Kunalverma1502/ESP-32-Drone-V2.0/README.md

# ESP-32-Drone-V2.0
ESP32 based mini drone
