Kunalverma1502/ESP-32-Drone-V2.0/Body/Body_Bottom.png

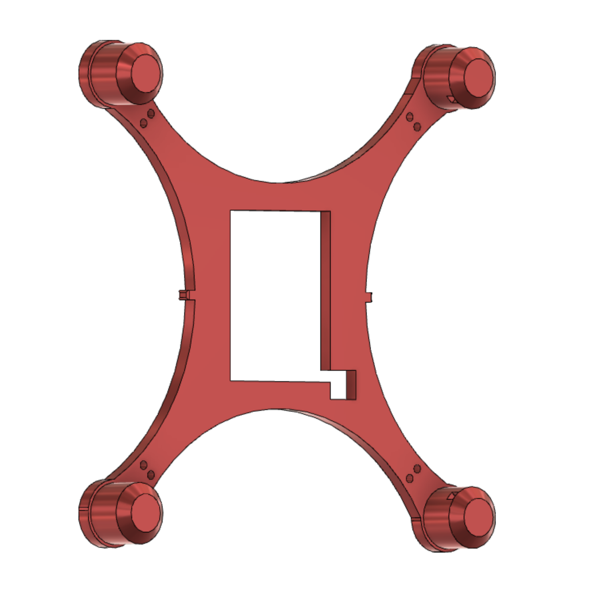
Body/Body_Bottom.png
