Kunalverma1502/ESP-32-Drone-V2.0/Body/Body_Top.png

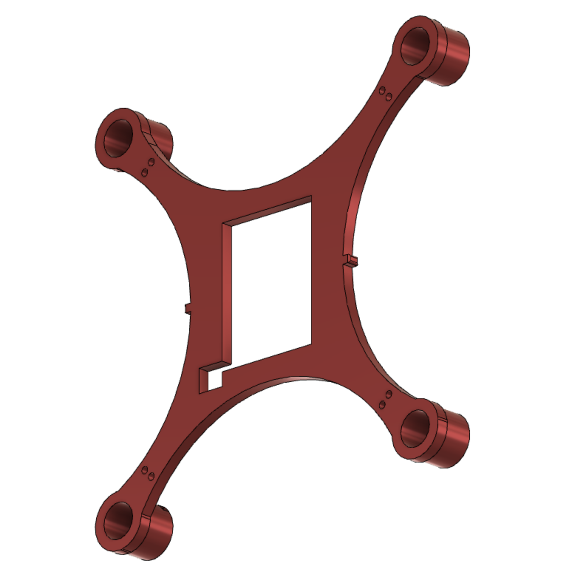
Body/Body_Top.png
