Kunalverma1502/ESP-32-Drone-V2.0/Body/new body v9.step

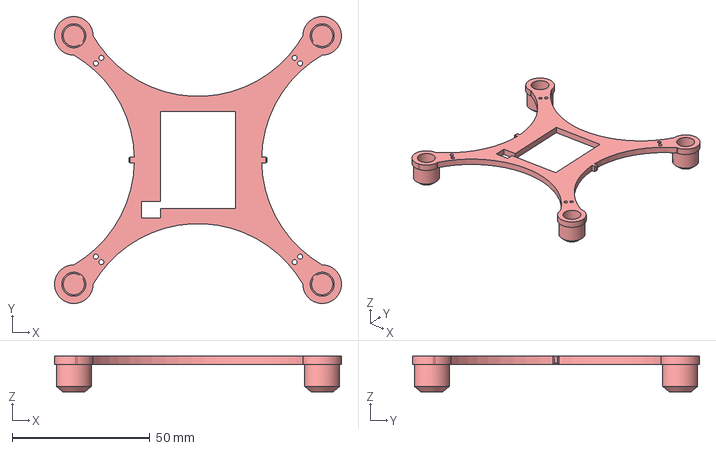
[picture p4: CAD file, 2023-05-19]
Body/new body v9.step
104.0 x 104.0 x 13.0 mm
