Kunalverma1502/ESP-32-Drone-V2.0/(list of files, cad)

Other CAD files:
Body/new body v9.f3z
Body/new body v9.obj
Body/new body v9.stl
