Kunalverma1502/ESP-32-Drone-V2.0/PCB and Schematics/DRONE ORIGNAL/drone.pdf

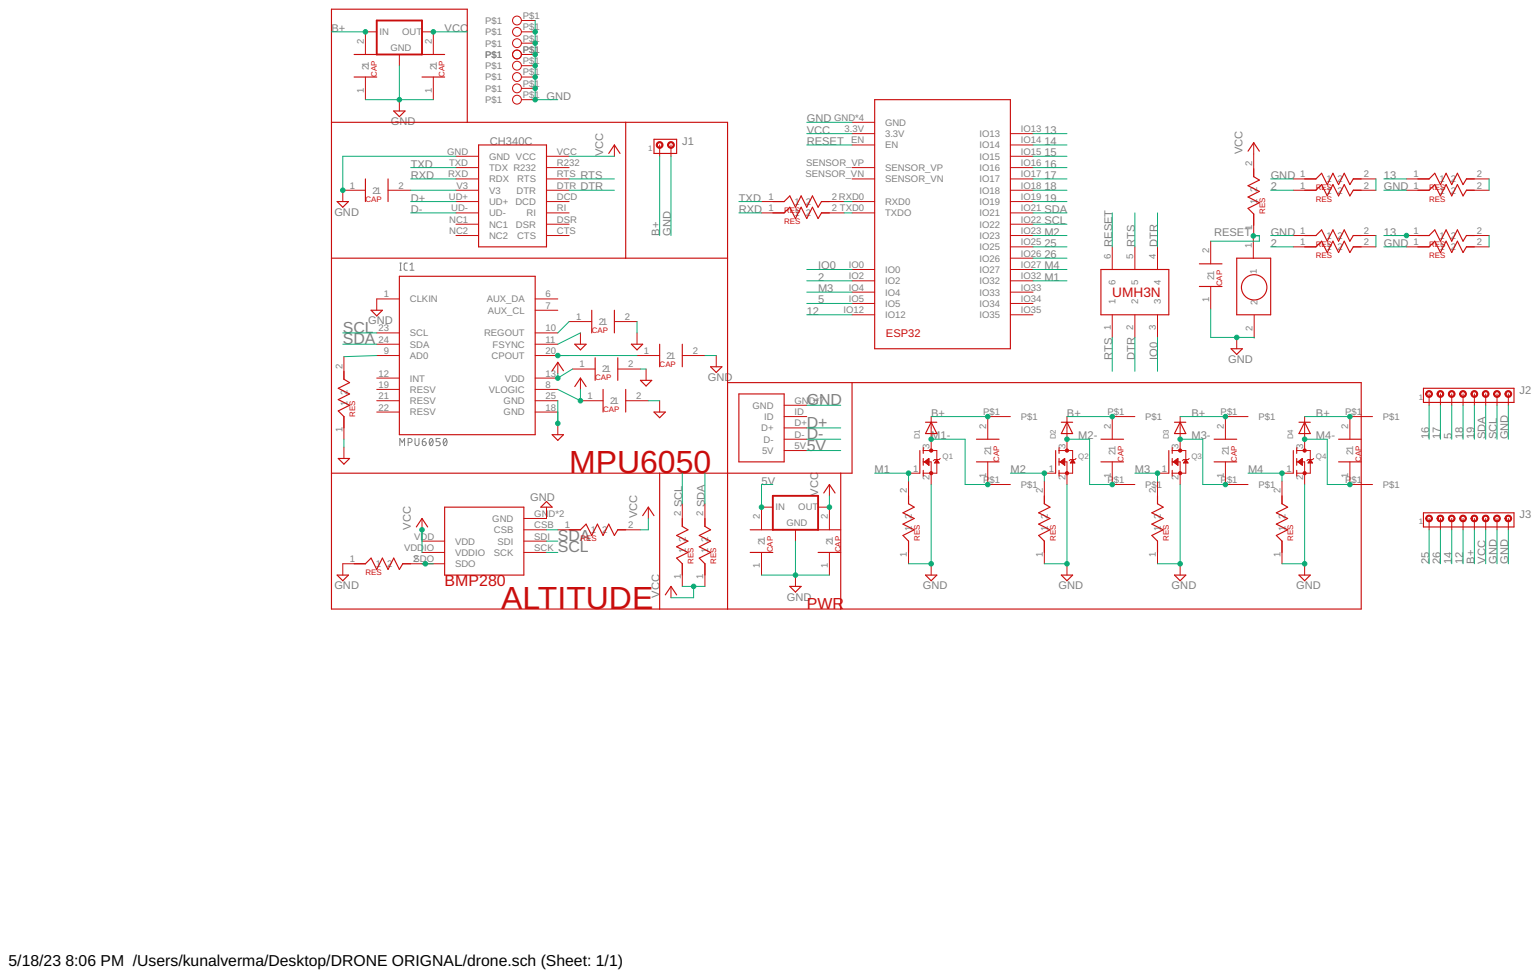
[picture p5: page 1]

GND | 5V

5/18/23 8:06 PM /Users/kunalverma/Desktop/DRONE ORIGNAL/drone.sch (Sheet: 1/1)
