Kunalverma1502/ESP-32-Drone-V2.0/PCB and Schematics/DRONE V2.0/DRONE V3.0.pdf

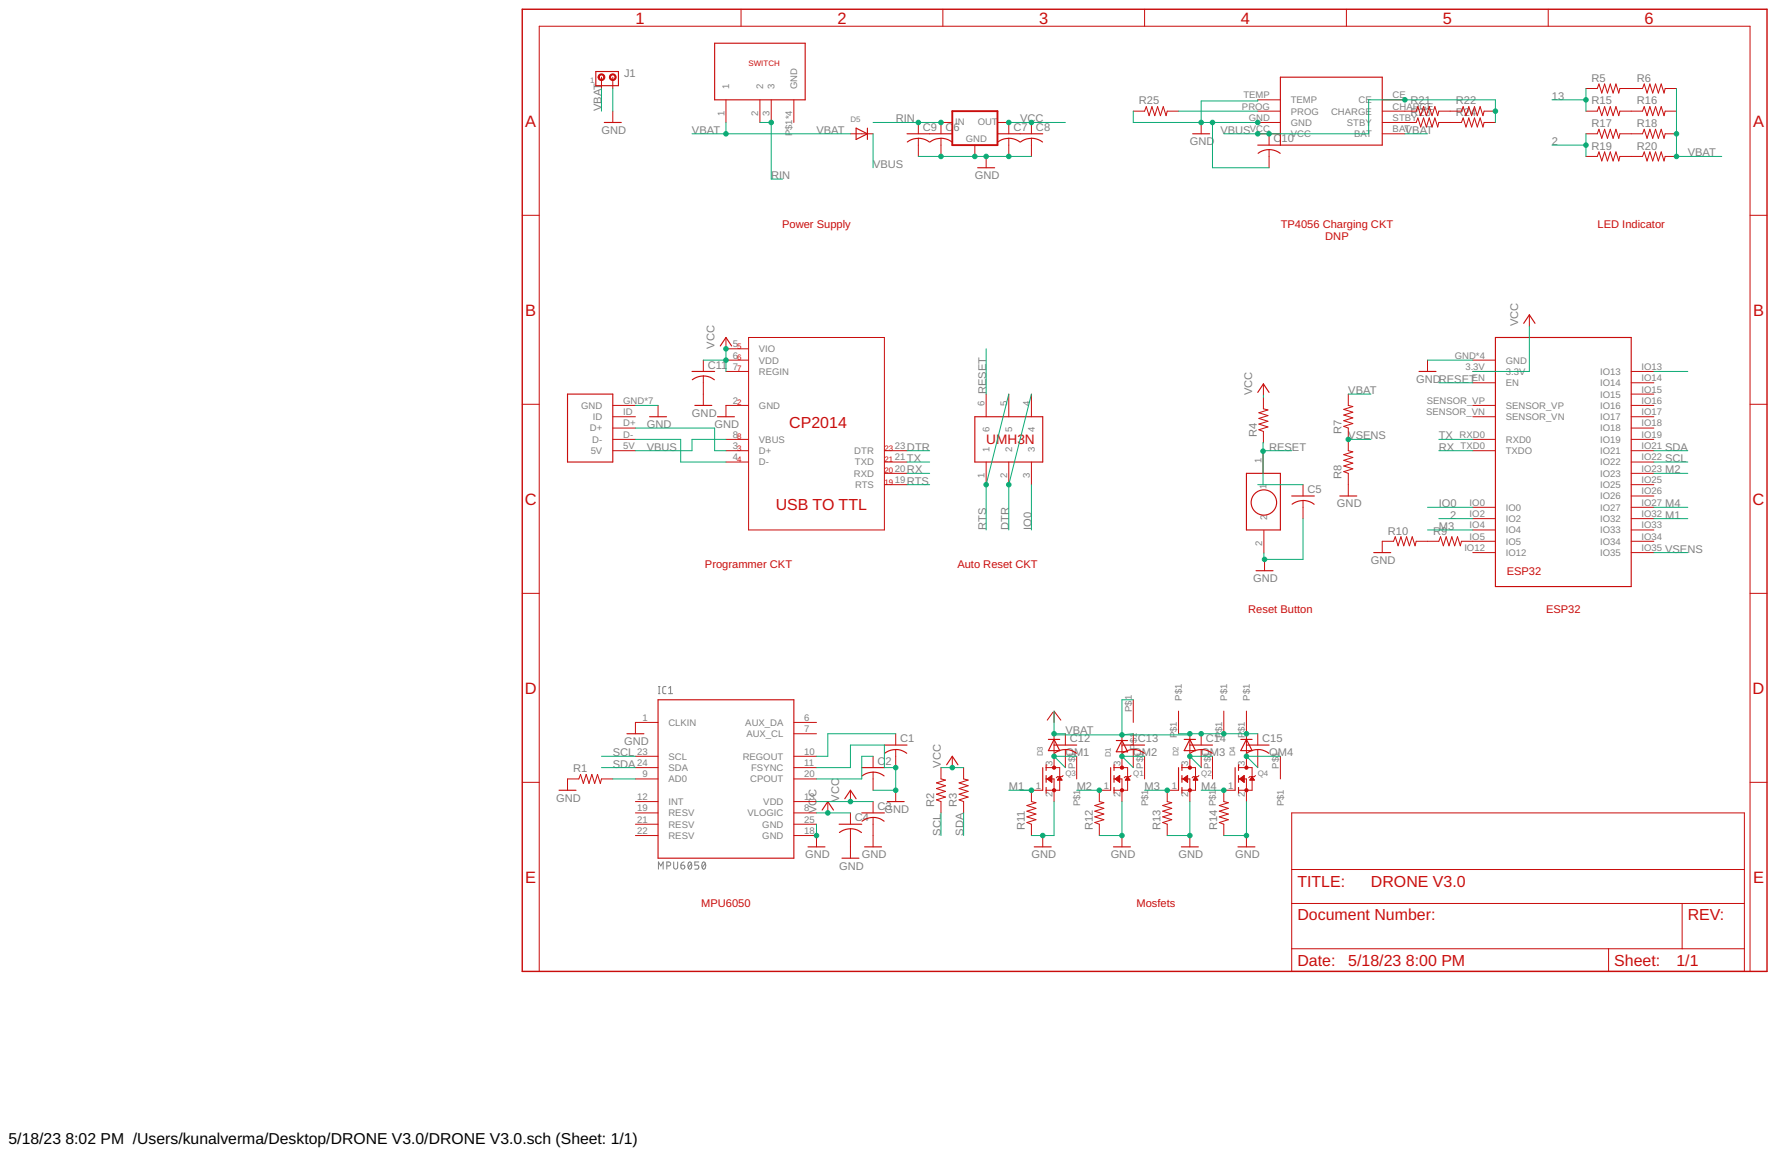
[picture p6: page 1]

Document Number: | REV:

Date: 5/18/23 8:00 PM | Sheet: 1/1

5/18/23 8:02 PM /Users/kunalverma/Desktop/DRONE V3.0/DRONE V3.0.sch (Sheet: 1/1)
