Kunalverma1502/ESP-32-Drone-V2.0/PCB and Schematics/DRONE V2.0/DRONE V3.0.brd

## EAGLE design PCB and Schematics/DRONE V2.0/DRONE V3.0.brd (2023-05-19)

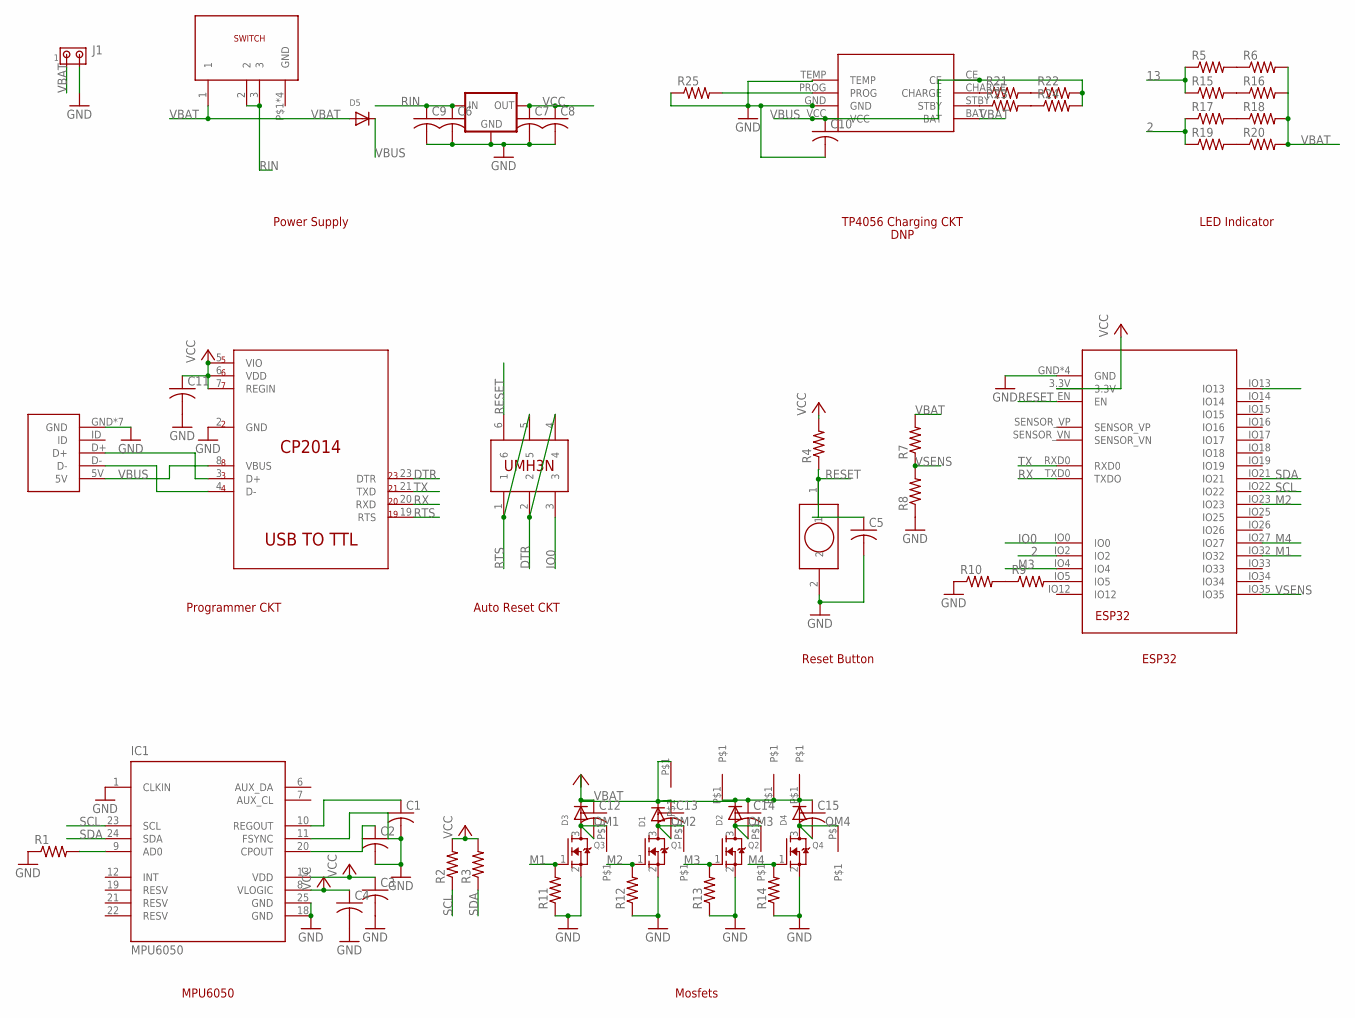
[picture p7: schematic DRONE V3.0.sch]

Parts:
C1, C2, C3, C4, C5, C6, C7, C8, C9, C10, C11, C12, C13, C14, C15: C-USC0603; C0603
D1, D2, D3, D4, D5: DIODESOD-323F; SOD-323F
IC1: MPU6050; QFN50P400X400X95-25T265X275N
IC2: V_REG1.8MP; SOT223
J1: MTA02-100; 10X02MTA
Q1, Q2, Q3, Q4: MOSFET-NREFLOW; SOT23
R1, R2, R3, R4, R5, R6, R7, R8, R9, R10, R11, R12, R13, R14, R15, R16, R17, R18, R19, R20, R21, R22, R23, R24, R25: R-US_R0603; R0603
U1: ESP32; MODULE_ESP-WROOM-32
U2: CP2104-F03-GM; QFN50P400X400X80-25N
U$1: MICROUSB; USB
U$2: SELF_PUSHBUTTON
U$3: SWITCH
U$4: TP4056
U$6: UMH3N
U$7, U$8, U$9, U$10, U$11, U$12, U$13, U$14: PINOUTS

Connections:
2: R17.1, R19.1, U1.IO2
13: R5.1, R15.1, U1.IO13
DTR: U2.23 (DTR), U$6.2, U$6.4
GND: C1.2, C2.2, C3.2, C4.2, C5.2, C6.2, C7.2, C8.2, C9.2, C10.2, C11.2, IC1.1 (CLKIN), IC1.11 (FSYNC), IC1.18 (GND), IC1.25 (GND), IC2.GND, J1.2, Q1.2 (S), Q2.2 (S), Q3.2 (S), Q4.2 (S), R1.1, R8.1, R10.1, R11.1, R12.1, R13.1, R14.1, R25.1, U1.GND, U1.GND1 (GND), U1.GND2 (GND), U1.GND3 (GND), U2.2 (GND), U$1.GND, U$1.GND1 (GND), U$1.GND2 (GND), U$1.GND3 (GND), U$1.GND4 (GND), U$1.GND5 (GND), U$1.GND6 (GND), U$2.2, U$4.GND, U$4.TEMP
IO0: U1.IO0, U$6.3
M1: Q3.1 (G), R11.2, U1.IO32
M2: Q1.1 (G), R12.2, U1.IO23
M3: Q2.1 (G), R13.2, U1.IO4
M4: Q4.1 (G), R14.2, U1.IO27
unnamed: IC1.9 (AD0), R1.2
unnamed: R5.2, R6.1
unnamed: R15.2, R16.1
unnamed: C1.1, IC1.10 (REGOUT)
unnamed: C2.1, IC1.20 (CPOUT)
unnamed: U2.3 (D+), U$1.D+
unnamed: U2.4 (D-), U$1.D-
unnamed: R9.2, U1.IO5
unnamed: R9.1, R10.2
unnamed: R17.2, R18.1
unnamed: R19.2, R20.1
unnamed: R21.1, U$4.CHARGE
unnamed: R21.2, R22.1
unnamed: R23.1, U$4.STBY
unnamed: R23.2, R24.1
unnamed: R25.2, U$4.PROG
OM1: C12.2, D3.A, Q3.3 (D), U$12.P$1
OM2: C13.2, D1.A, Q1.3 (D), U$8.P$1
OM3: C14.2, D2.A, Q2.3 (D), U$10.P$1
OM4: C15.2, D4.A, Q4.3 (D), U$13.P$1
RESET: C5.1, R4.1, U1.EN, U$2.1, U$6.6
RIN: C6.1, C9.1, IC2.VIN (IN), U$3.2, U$3.3
RTS: U2.19 (RTS), U$6.1, U$6.5
RX: U1.TXD0 (TXDO), U2.20 (RXD)
SCL: IC1.23 (SCL), R2.1, U1.IO22
SDA: IC1.24 (SDA), R3.1, U1.IO21
TX: U1.RXD0, U2.21 (TXD)
VBAT: C12.1, C13.1, C14.1, C15.1, D1.C, D2.C, D3.C, D4.C, D5.A, J1.1, R6.2, R7.2, R16.2, R18.2, R20.2, U$3.1, U$4.BAT, U$7.P$1, U$9.P$1, U$11.P$1, U$14.P$1
VBUS: C10.1, D5.C, R22.2, R24.2, U2.8 (VBUS), U$1.5V, U$4.CE, U$4.VCC
VCC: C3.1, C4.1, C7.1, C8.1, C11.1, IC1.8 (VLOGIC), IC1.13 (VDD), IC2.VOUT (OUT), IC2.VOUT1 (OUT), R2.2, R3.2, R4.2, U1.3.3V, U2.5 (VIO), U2.6 (VDD), U2.7 (REGIN)
VSENS: R7.1, R8.2, U1.IO35

Notes on the sheet:
Power Supply
TP4056 Charging CKT
DNP
LED Indicator
Programmer CKT
Auto Reset CKT
Reset Button
ESP32
MPU6050
Mosfets

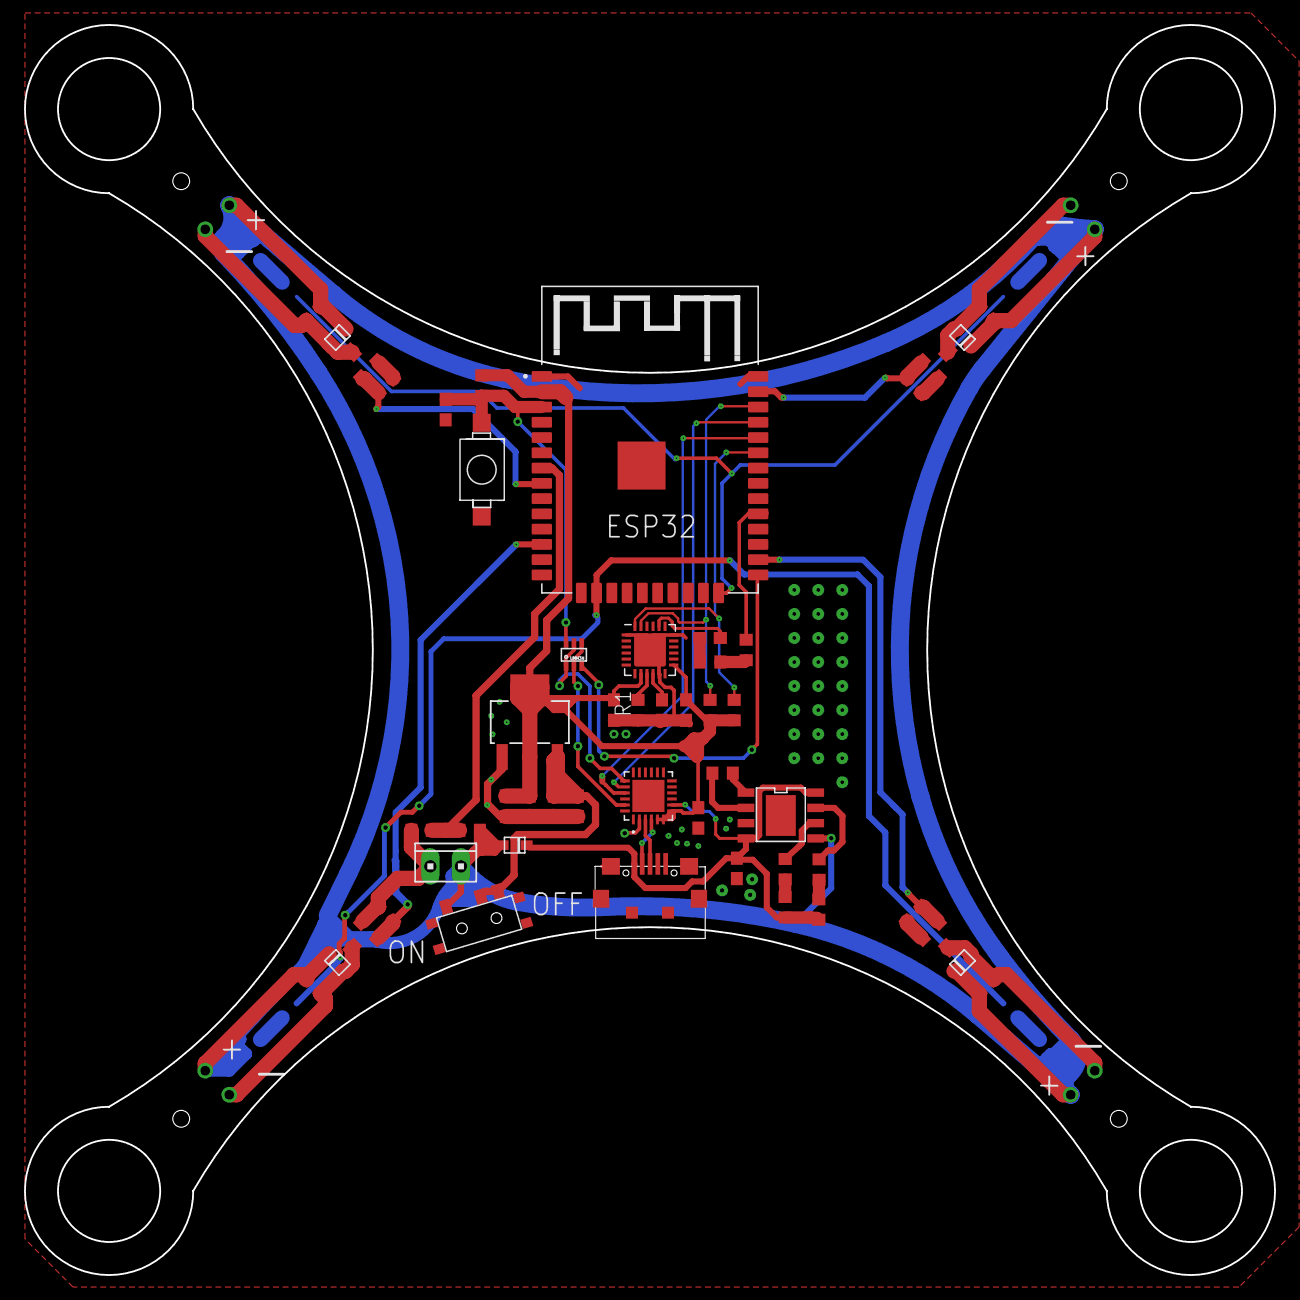
[picture p8: board DRONE V3.0.brd from above]

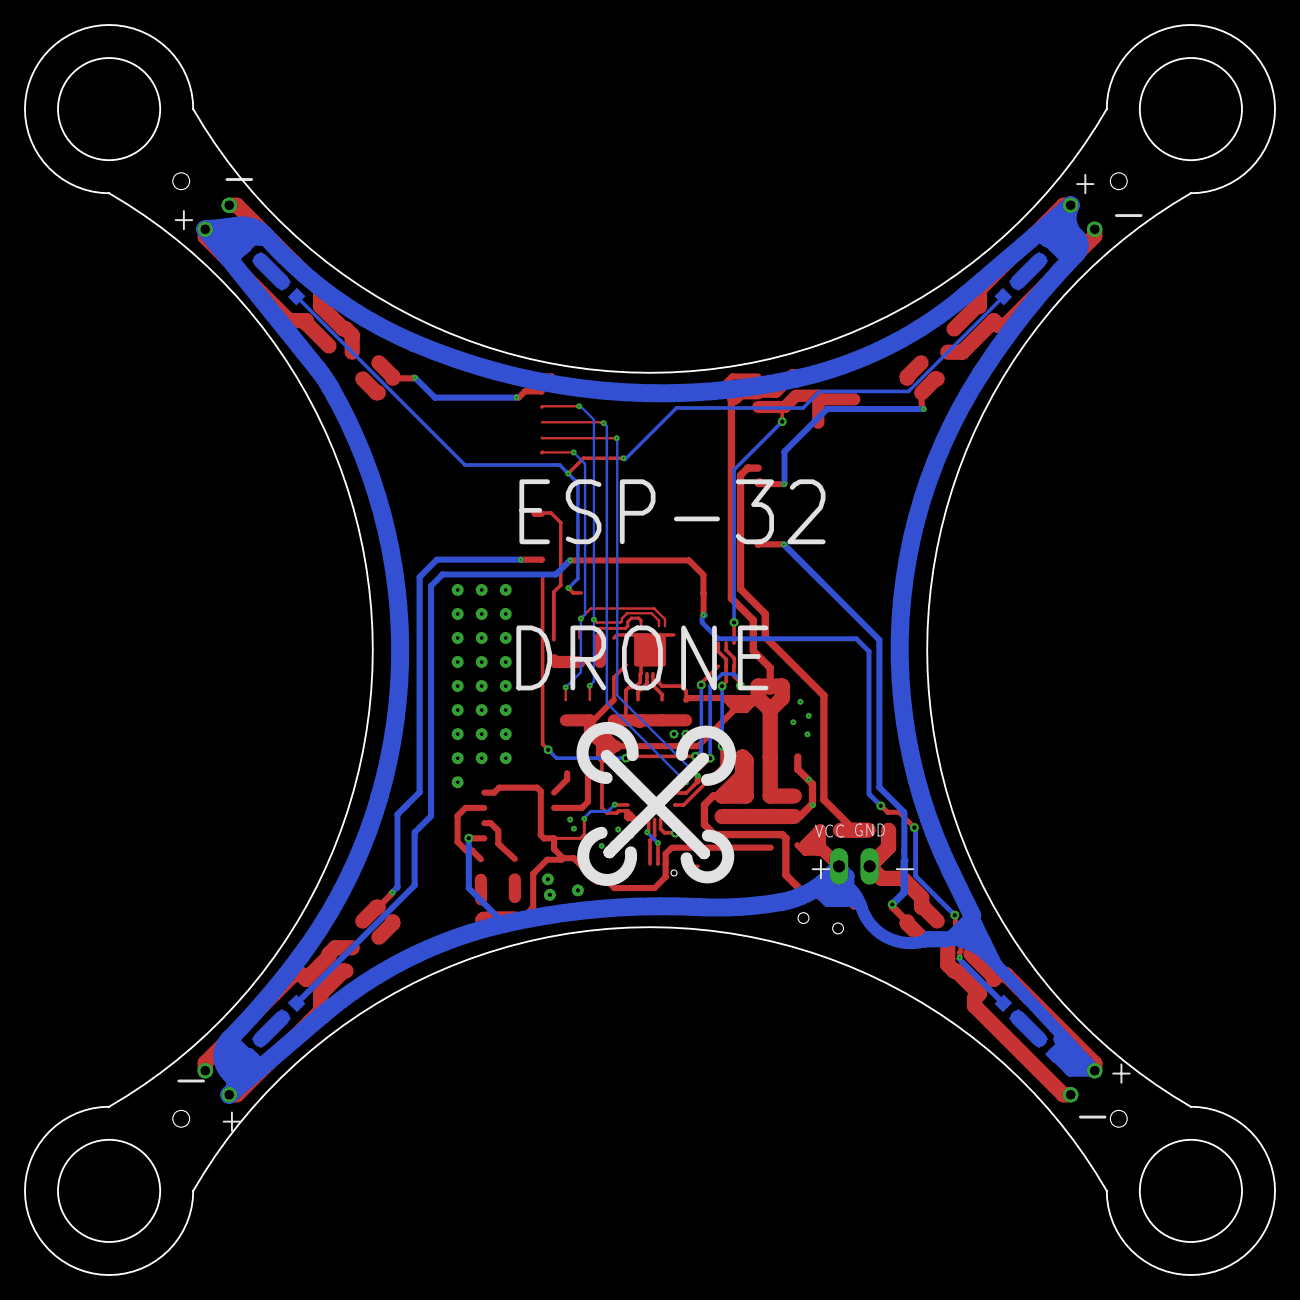
[picture p9: board DRONE V3.0.brd from below]

Board: 2 copper layers, 104.0 x 104.0 mm, 67 parts (8 on the bottom side), 40 nets.
