Kunalverma1502/ESP-32-Drone-V2.0/PCB and Schematics/DRONE ORIGNAL/drone.brd

## EAGLE design PCB and Schematics/DRONE ORIGNAL/drone.brd (2023-05-19)

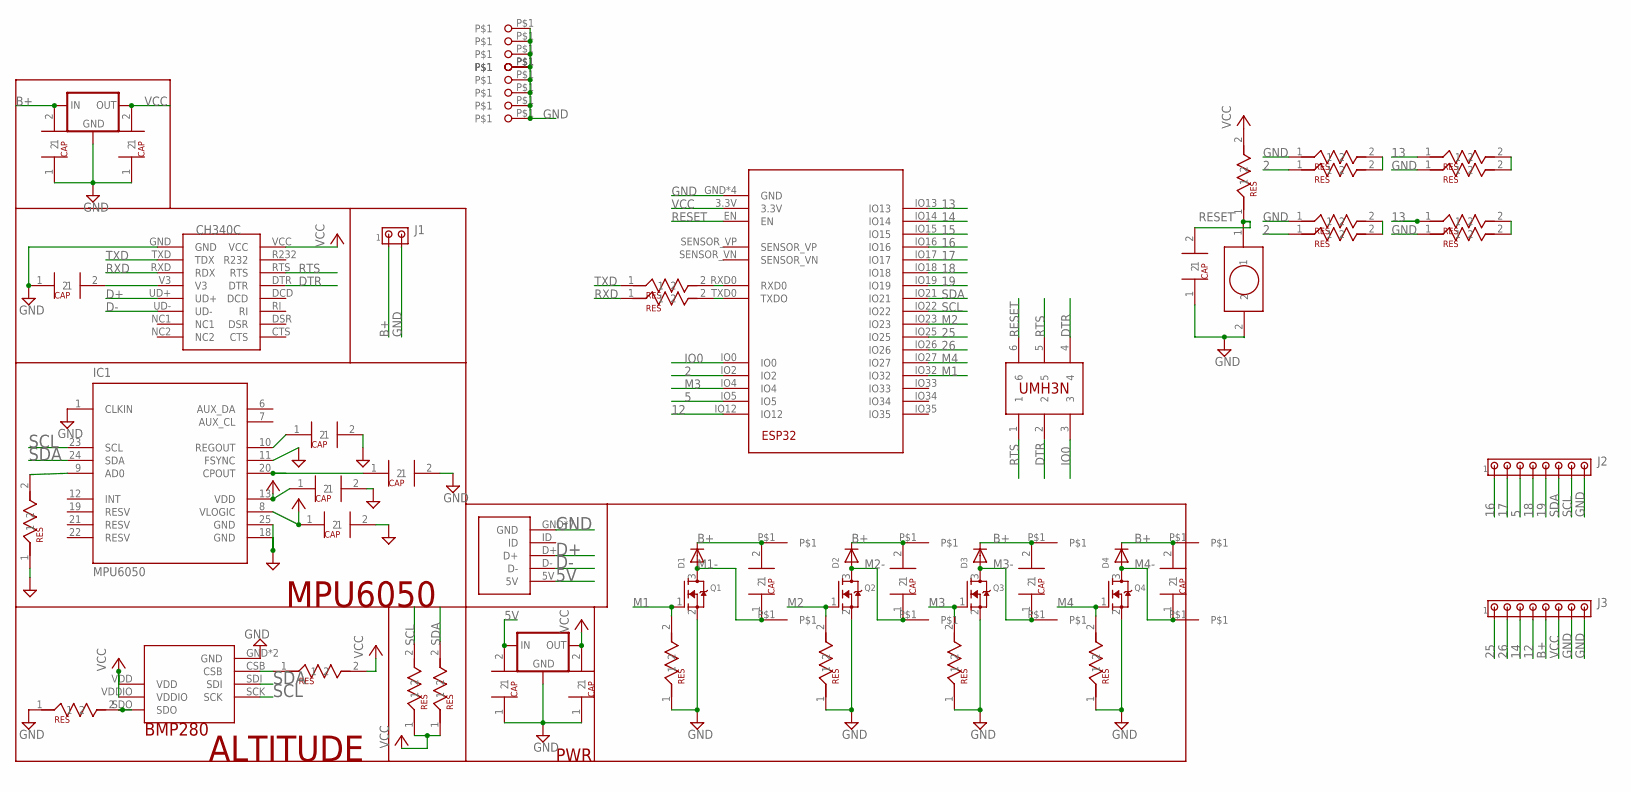
[picture p10: schematic drone.sch]

Parts:
D1, D2, D3, D4: DIODESOD-323F; SOD-323F
IC1: MPU6050; QFN50P400X400X95-25T265X275N
IC2, IC3: SELF_VREG3.3MP; SOT223
J1: MTA02-100; 10X02MTA
J2, J3: MTA08-100; 10X08MTA
Q1, Q2, Q3, Q4: MOSFET-NREFLOW; SOT23
U1: ESP32; MODULE_ESP-WROOM-32
U$1: MICROUSB; USB
U$2: CH340C; SOIC16
U$3: BMP280
U$4, U$5, U$7, U$11, U$12, U$16, U$17, U$20, U$21, U$22, U$23, U$30, U$32, U$33, U$34, U$35, U$36, U$37, U$38, U$39: SELF_RESISTOR_0603
U$6, U$8, U$9, U$10, U$15, U$24, U$25, U$26, U$27, U$31: SELF_CAP_0603
U$13, U$14, U$18, U$19: SELF_CAP_0603SELF_CAP_0805; SELF_CAP_0805
U$28: UMH3N
U$29: SELF_PUSHBUTTON
U$40, U$41, U$42, U$43, U$44, U$45, U$46, U$47: SELF_PINOUTS; PINOUTS
U$48, U$49, U$50, U$51, U$52, U$53, U$54, U$55, U$56: SELF_PIN2; PIN2

Connections:
2: U1.IO2, U$33.1, U$39.1
5: J2.3, U1.IO5
5V: IC2.VIN (IN), U$1.5V, U$13.2
12: J3.4, U1.IO12
13: U1.IO13, U$34.1, U$36.1
14: J3.3, U1.IO14
15: U1.IO15
16: J2.1, U1.IO16
17: J2.2, U1.IO17
18: J2.4, U1.IO18
19: J2.5, U1.IO19
25: J3.1, U1.IO25
26: J3.2, U1.IO26
B+: D1.C, D2.C, D3.C, D4.C, IC3.VIN (IN), J1.1, J3.5, U$19.2, U$24.2, U$25.2, U$26.2, U$27.2, U$40.P$1, U$42.P$1, U$44.P$1, U$46.P$1
D+: U$1.D+, U$2.UD+
D-: U$1.D-, U$2.UD-
DTR: U$2.DTR, U$28.2, U$28.4
GND: IC1.1 (CLKIN), IC1.11 (FSYNC), IC1.18 (GND), IC1.25 (GND), IC2.GND, IC3.GND, J1.2, J2.8, J3.7, J3.8, Q1.2 (S), Q2.2 (S), Q3.2 (S), Q4.2 (S), U1.GND, U1.GND1 (GND), U1.GND2 (GND), U1.GND3 (GND), U$1.GND, U$1.GND1 (GND), U$1.GND2 (GND), U$1.GND3 (GND), U$1.GND4 (GND), U$1.GND5 (GND), U$1.GND6 (GND), U$2.GND, U$3.GND, U$3.GND1 (GND), U$5.1, U$6.2, U$7.1, U$8.2, U$9.2, U$10.2, U$13.1, U$14.1, U$15.1, U$18.1, U$19.1, U$20.1, U$21.1, U$22.1, U$23.1, U$29.2, U$31.1, U$32.1, U$35.1, U$37.1, U$38.1, U$48.P$1, U$49.P$1, U$50.P$1, U$51.P$1, U$52.P$1, U$53.P$1, U$54.P$1, U$55.P$1, U$56.P$1
IO0: U1.IO0, U$28.3
M1: Q1.1 (G), U1.IO32, U$20.2
M1-: D1.A, Q1.3 (D), U$24.1, U$41.P$1
M2: Q2.1 (G), U1.IO23, U$21.2
M2-: D2.A, Q2.3 (D), U$26.1, U$43.P$1
M3: Q3.1 (G), U1.IO4, U$22.2
M3-: D3.A, Q3.3 (D), U$27.1, U$45.P$1
M4: Q4.1 (G), U1.IO27, U$23.2
M4-: D4.A, Q4.3 (D), U$25.1, U$47.P$1
unnamed: U$32.2, U$33.2
unnamed: U$38.2, U$39.2
unnamed: U$34.2, U$35.2
unnamed: U$36.2, U$37.2
unnamed: U$3.SDO, U$5.2
unnamed: U$3.CSB, U$4.1
unnamed: IC1.9 (AD0), U$7.2
unnamed: IC1.10 (REGOUT), U$8.1
unnamed: IC1.20 (CPOUT), U$10.1
unnamed: U1.RXD0, U$16.2
unnamed: U1.TXD0 (TXDO), U$17.2
unnamed: U$2.V3, U$15.2
RESET: U1.EN, U$28.6, U$29.1, U$30.1, U$31.2
RTS: U$2.RTS, U$28.1, U$28.5
RXD: U$2.RXD (RDX), U$17.1
SCL: IC1.23 (SCL), J2.7, U1.IO22, U$3.SCK, U$11.2
SDA: IC1.24 (SDA), J2.6, U1.IO21, U$3.SDI, U$12.2
TXD: U$2.TXD (TDX), U$16.1
VCC: IC1.8 (VLOGIC), IC1.13 (VDD), IC2.VOUT (OUT), IC2.VOUT1 (OUT), IC3.VOUT (OUT), IC3.VOUT1 (OUT), J3.6, U1.3.3V, U$2.VCC, U$3.VDD, U$3.VDDIO, U$4.2, U$6.1, U$9.1, U$11.1, U$12.1, U$14.2, U$18.2, U$30.2

Notes on the sheet:
ALTITUDE
MPU6050
PWR

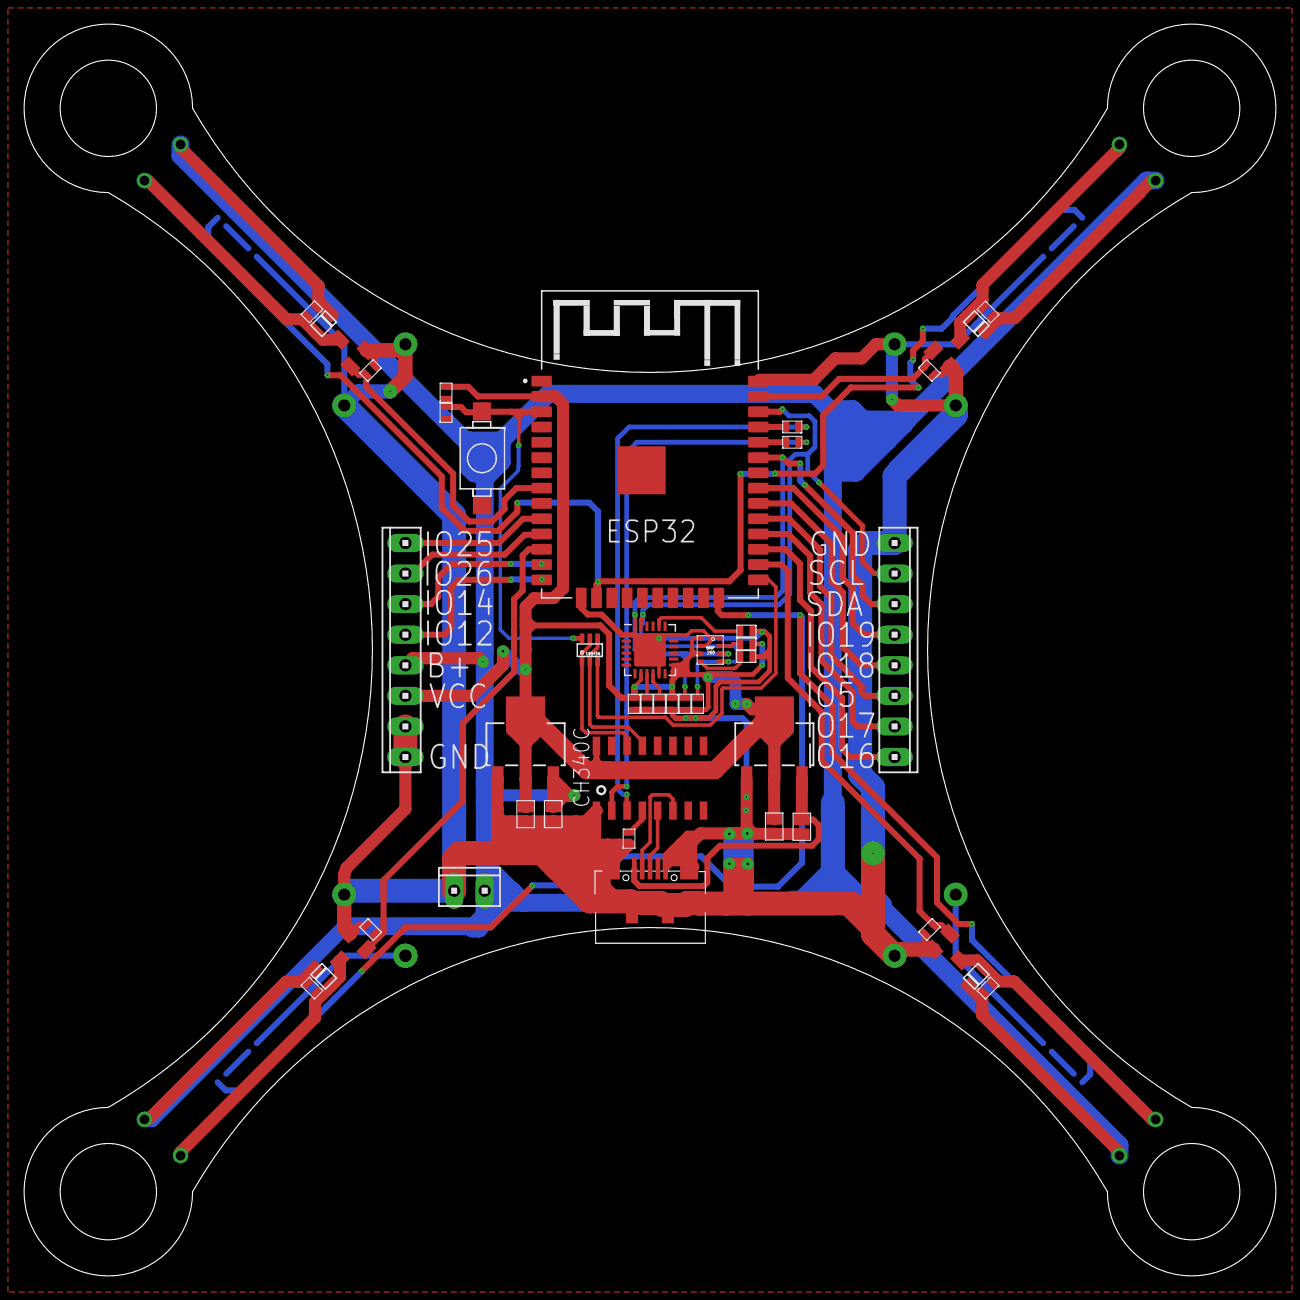
[picture p11: board drone.brd from above]

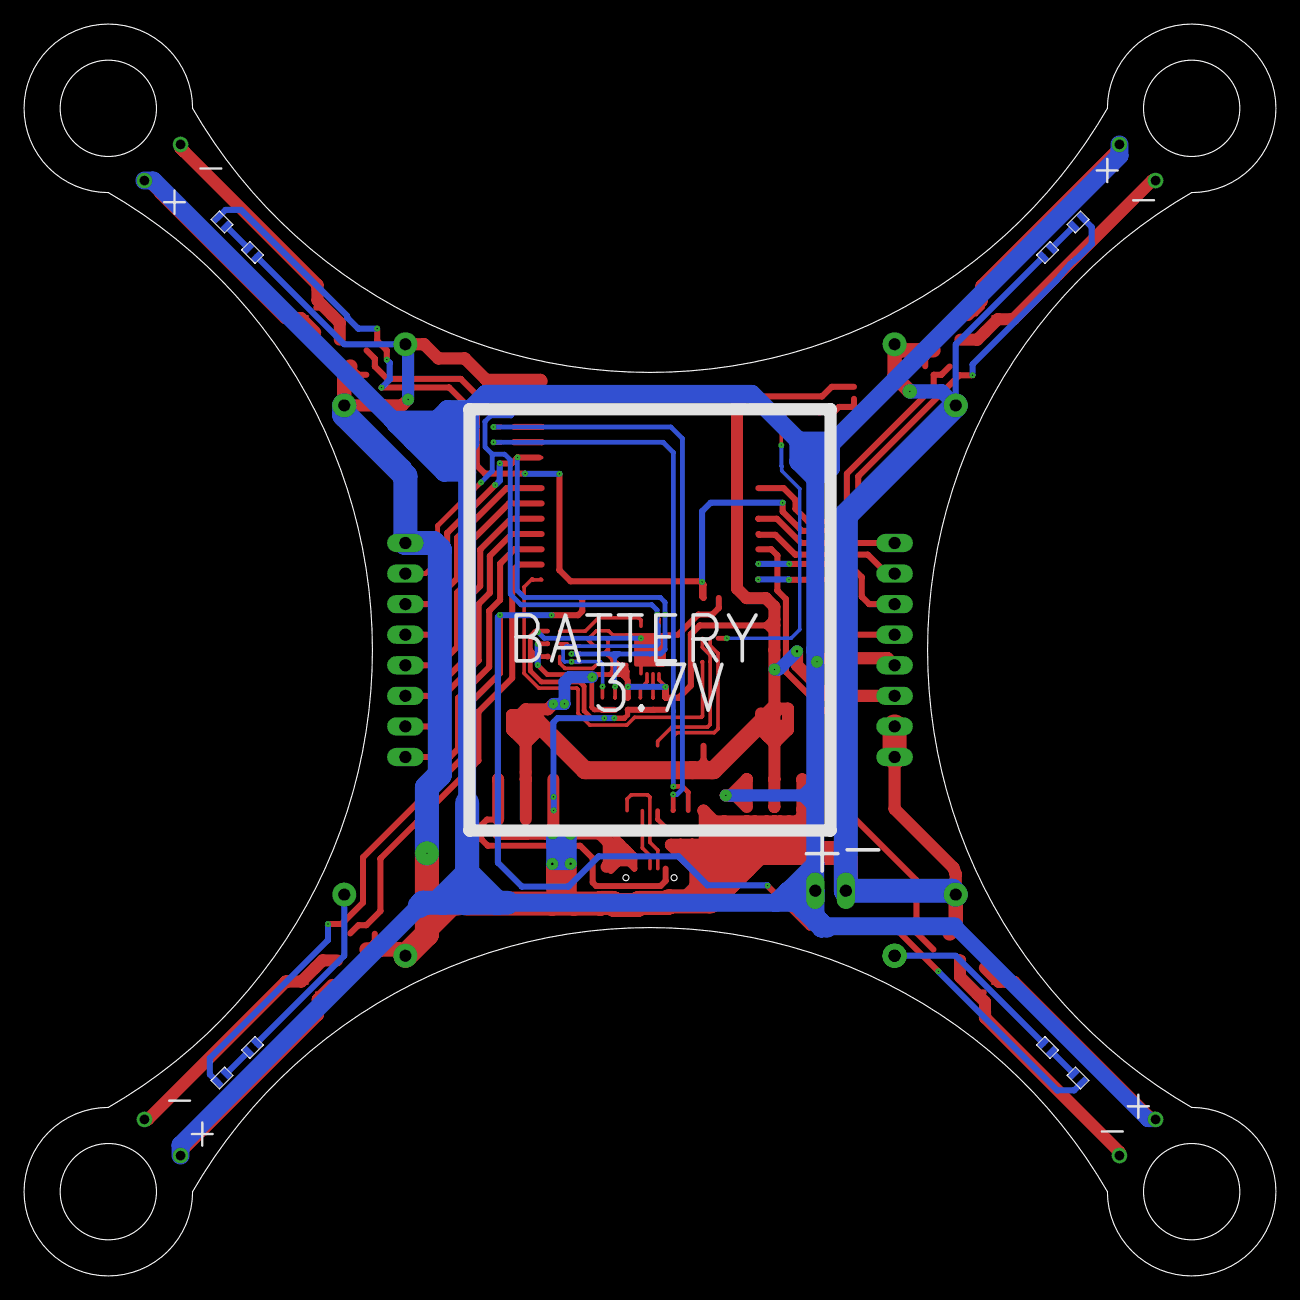
[picture p12: board drone.brd from below]

Board: 2 copper layers, 104.0 x 104.0 mm, 71 parts (8 on the bottom side), 45 nets.
